sujanregmi99/vbedas/pcb.png

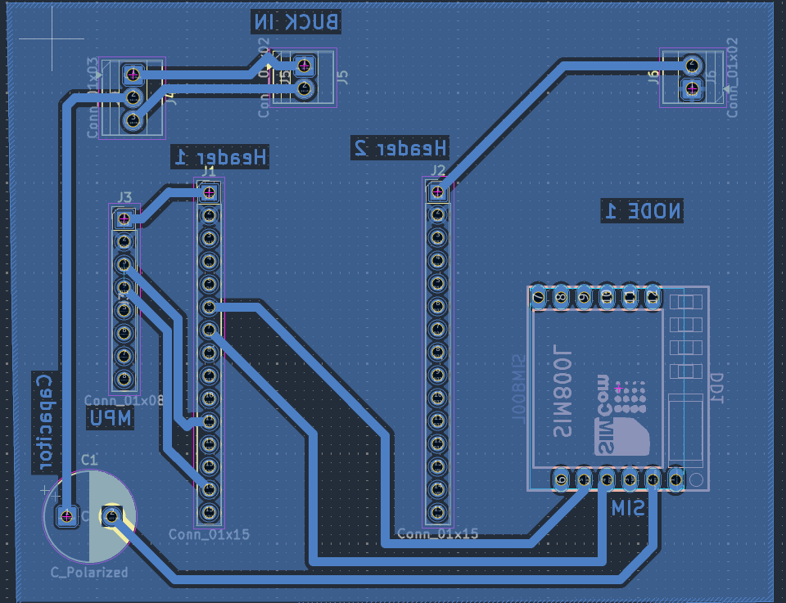
pcb.png
